tpmanley/dogcage/(list of files, cad)

Other CAD files:
mech/doorarm.skp
mech/servoarm.skp
mech/servomount.skp
