tpmanley/dogcage/hw/dogcage.pdf

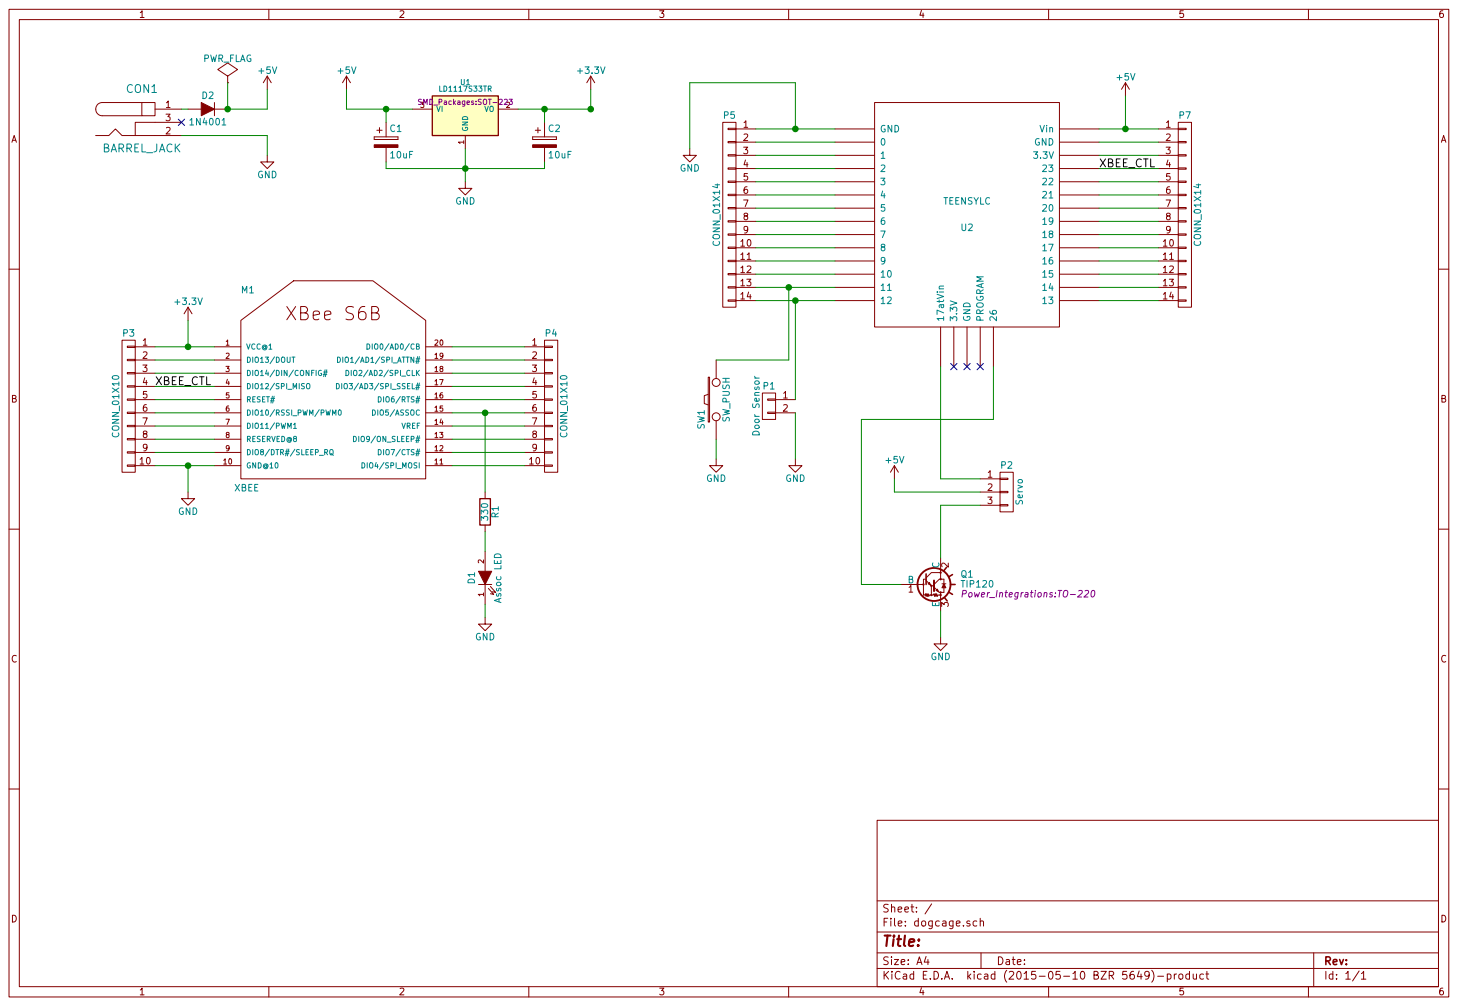
[picture p1: page 1]

4 | XBEE_CTL | 4
10 | 10
11 | 11
12 | 12
13 | 13

File: dogcage.sch Sheet: /
Id: 1/1 Title:
