tpmanley/dogcage/hw/dogcage.kicad_pcb

## KiCad design hw/dogcage.kicad_pcb (2015-08-02)

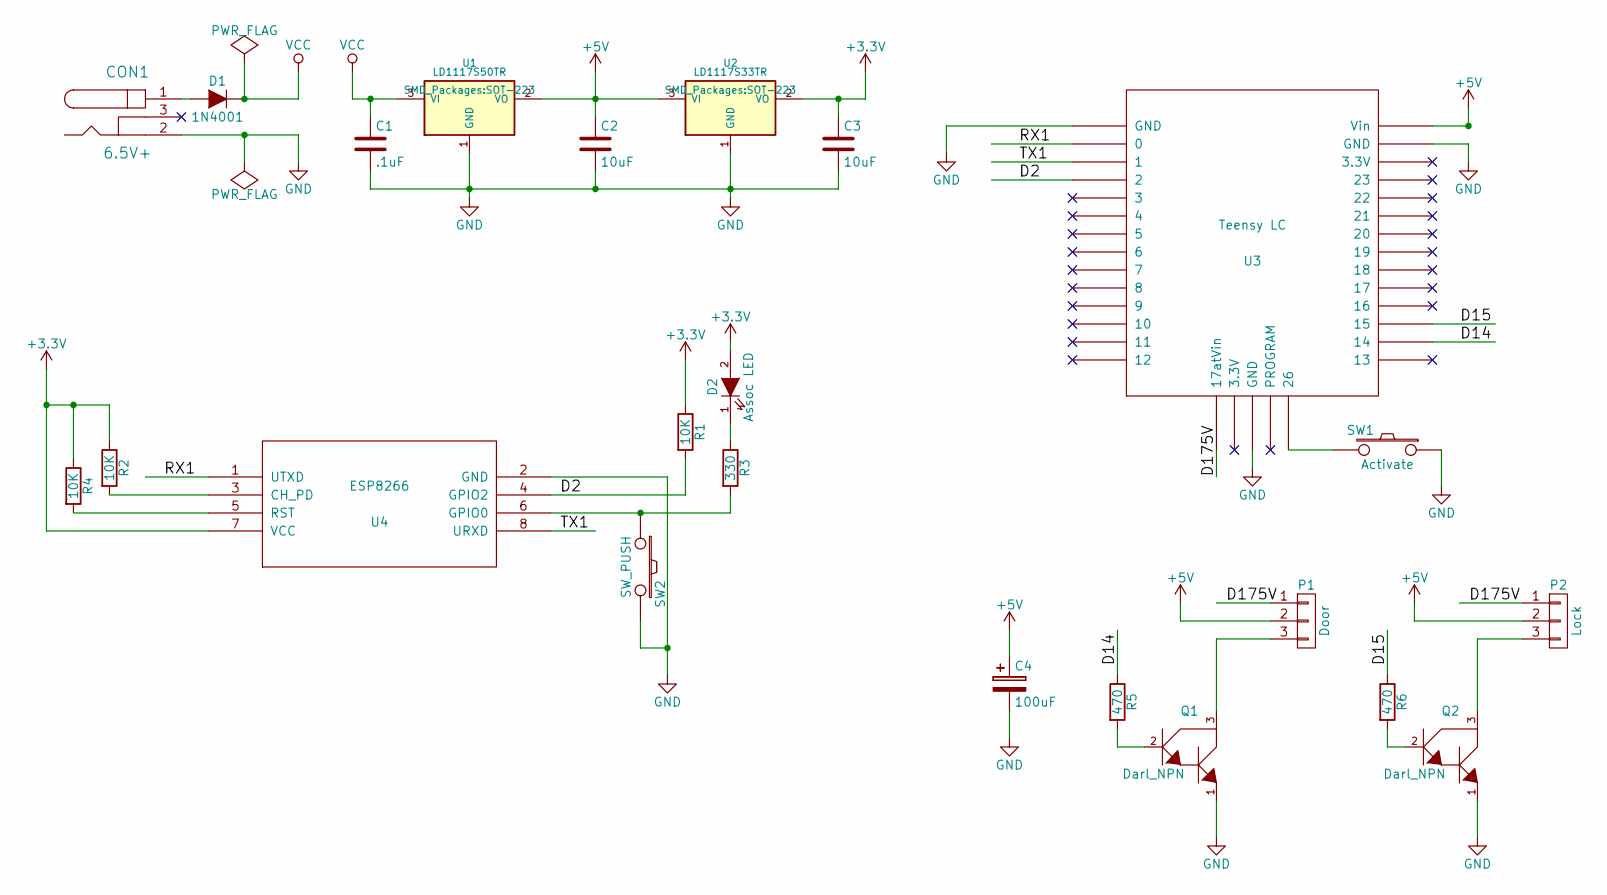
[picture p2: schematic dogcage.sch]

Parts:
C1: .1uF; C_0805_HandSoldering
C2, C3: 10uF; C_0805_HandSoldering
C4: 100uF; c_elec_3x5.3
CON1: 6.5V+; BARREL_JACK-ROUND_TH
D1: 1N4001; Diode_DO-41_SOD81_Horizontal_RM10
D2: Assoc LED; LED-0805
P1: Door; Pin_Header_Straight_1x03
P2: Lock; Pin_Header_Straight_1x03
Q1, Q2: Darl_NPN; DPAK-2
R1, R2, R4: 10K; R_0805_HandSoldering
R3: 330; R_0805_HandSoldering
R5, R6: 470; R_0805_HandSoldering
SW1: Activate; SW_PUSH_SMALL
SW2: SW_PUSH; SW_SPST_FSMSM
U1: LD1117S50TR; SOT-223
U2: LD1117S33TR; SOT-223
U3: Teensy LC; Teensy-3.1
U4: ESP8266; ESP-01

Connections:
+3V3: C3.1, D2.2 (A), R1.1, R2.1, R4.1, U2.2 (VO), U4.7 (VCC)
+5V: C2.1, C4.1, P1.2, P2.2, U1.2 (VO), U2.3 (VI), U3.33 (Vin)
/D2: R1.2, U3.4 (2), U4.4 (GPIO2)
/D14: R5.1, U3.21 (14)
/D15: R6.1, U3.22 (15)
/D175V: P1.1, P2.1, U3.15 (17atVin)
/RX1: U3.2 (0), U4.1 (UTXD)
/TX1: U3.3 (1), U4.8 (URXD)
GND: C1.2, C2.2, C3.2, C4.2, CON1.2, Q1.1, Q2.1, SW1.1, SW2.2, U1.1 (GND), U2.1 (GND), U3.1 (GND), U3.17 (GND), U3.32 (GND), U4.2 (GND)
unnamed: CON1.1, D1.2 (A)
unnamed: D2.1 (K), R3.1
unnamed: P1.3, Q1.3
unnamed: P2.3, Q2.3
unnamed: Q1.2, R5.2
unnamed: Q2.2, R6.2
unnamed: R2.2, U4.3 (CH_PD)
unnamed: R3.2, SW2.1, U4.6 (GPIO0)
unnamed: R4.2, U4.5 (RST)
unnamed: SW1.2, U3.19 (26)
VCC: C1.1, D1.1 (K), U1.3 (VI)

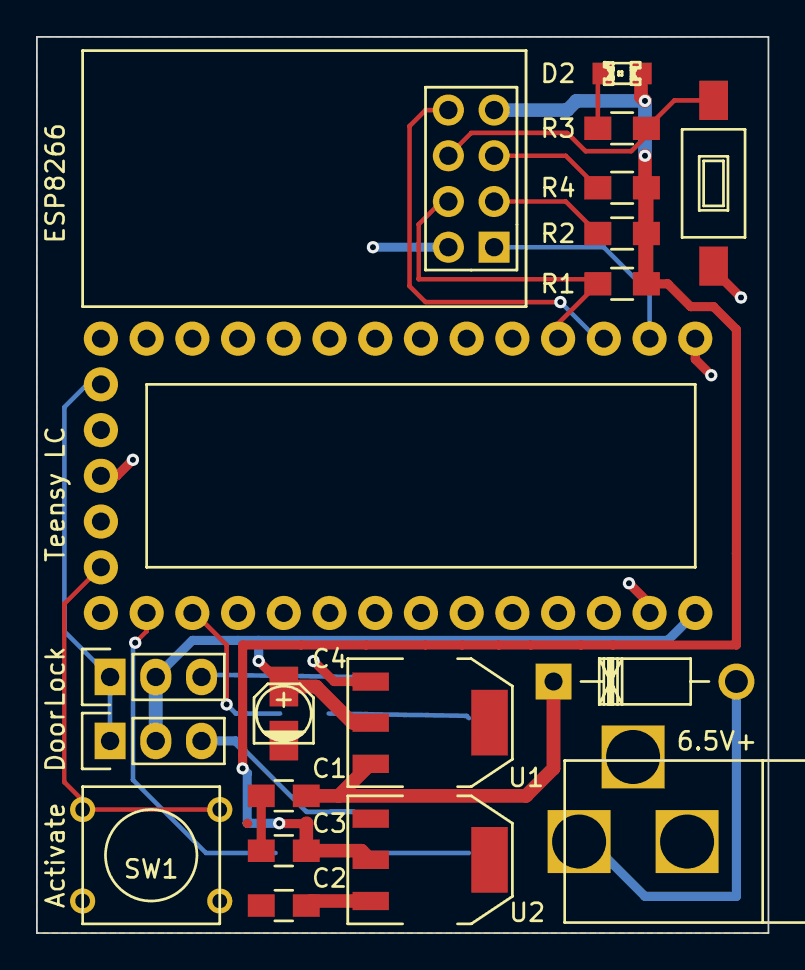
[picture p3: board dogcage.kicad_pcb from above]

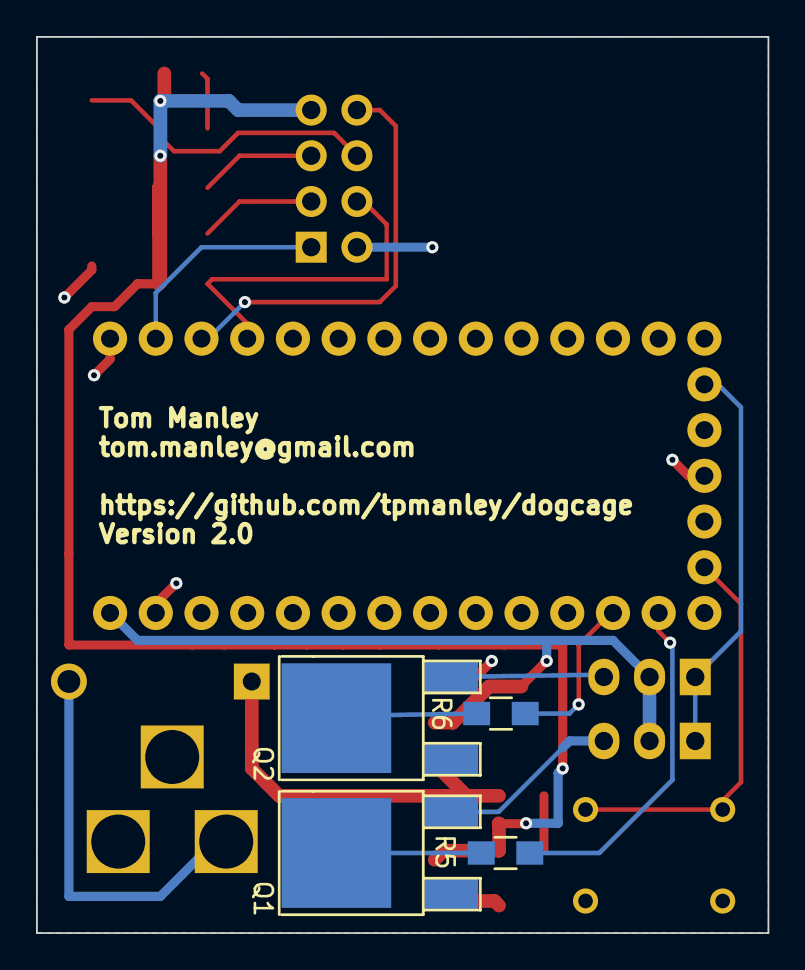
[picture p4: board dogcage.kicad_pcb from below]

Board: 2 copper layers, 40.6 x 49.8 mm, 23 parts (4 on the bottom side), 20 nets.
