tpmanley/dogcage/(threads)

Thread 4 (2015-06-17):

Resistor on Q1

Circuitsoft, 2015-06-17:
The TIP120 has a B-E voltage drop of 2.5v max, and an hFE around 2500 at a 4A load. Having the transistor directly connected to the pin on the teensy could be potentially damaging to the I/O pin. A 470 ohm resistor will provide almost 2mA, which should be plenty to saturate the TIP120. I would also recommend a bulk filter capacitor (100uF or so) across power to the servo to make sure current draw pulses don't cause random resets in the controllers.

tpmanley, 2015-06-18:
Thanks for the review Alex! You made great points and I updated the schematic.

Closed 2015-06-18.
