tpmanley/dogcage/(commit log)

2015-04-18 Initial commit for arduino powered dog cage opener
2015-04-18 LED will now always blink in loop
2015-04-25 Added door open/close sensor
2015-04-26 Button now has pullup and just connects pin to ground
2015-04-26 Added pullup to door sensor which is now connected from pin to ground
2015-04-26 Initial commit of kicad schematic
    [dogcage.sch]
2015-04-26 Cleaned up schematic and fixed ERC errors
    [dogcage.sch]
2015-04-26 Added assoc LED and started on PCB
    [dogcage.kicad_pcb, dogcage.sch]
2015-04-30 Add protection diode to input power line
    [dogcage.sch]
2015-05-02 Added connectors to XBee and Teensy
    [dogcage.sch]
2015-05-16 Fixed diode orientation and layout WIP
    [dogcage.kicad_pcb, dogcage.sch]
2015-05-16 Fixed cap and resistor footprints, improved overall placement
    [dogcage.kicad_pcb]
2015-05-17 Fixed orientation of LED
    [dogcage.sch]
2015-05-17 Moved XBee control line to make layout easier
    [dogcage.sch]
2015-05-17 Layout checkpoint
    [dogcage.kicad_pcb]
2015-05-19 Routing complete
    [dogcage.kicad_pcb, dogcage.sch]
2015-05-19 Updated design rules for oshpark, getting drc failures on vias
    [dogcage.kicad_pcb]
2015-05-22 Fixed drc failure, moved trace out of keep-out zone
    [dogcage.kicad_pcb]
2015-05-22 Generated gerbers and drill file
    [dogcage-B_Cu.gbl, dogcage-B_Mask.gbs, dogcage-B_SilkS.gbo, dogcage-Edge_Cuts.gbr, dogcage-F_Cu.gtl, dogcage-F_Mask.gts, dogcage-F_SilkS.gto, dogcage.drl]
2015-05-22 Fixed front silkscreen, added name/email to back
    [dogcage.kicad_pcb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]
2015-05-22 Removed P2 from front silkscreen
    [dogcage.kicad_pcb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]
2015-05-22 Added 'Trigger' to silkscreen
    [dogcage-B_Cu.gbl, dogcage-B_Mask.gbs, dogcage-B_SilkS.gbo, dogcage-Edge_Cuts.gbr, dogcage-F_Cu.gtl, dogcage-F_Mask.gts, dogcage-F_SilkS.gto, dogcage.drl]
2015-05-26 Initial commit of servo arm sketchup
    [servoarm.skp]
2015-05-26 Servo arm now one continguous piece
    [servoarm.skp, servoarm~.skp]
2015-06-01 First version of doorarm
    [doorarm.skp]
2015-06-01 Fit in flat servo connector instead of spline
    [servoarm.skp, servoarm~.skp]
2015-06-03 Arm now engulfs the servo horn
    [servoarm.skp]
2015-06-04 Updated door arm design to match servo arm design
    [doorarm.skp]
2015-06-04 Modified for 3d print compatibility. Printed 6-3-15.
    [servoarm.skp]
2015-06-04 Added rounded end to part that attaches to the cage
    [doorarm.skp]
2015-06-05 First version of servo mount
    [servomount.skp]
2015-06-05 Wrap around entire servo
    [servomount.skp]
2015-06-07 Changed screw holes to 1.1mm radius
    [servomount.skp]
2015-06-09 Models as printed revision 1.
    [doorarm.skp, servomount.skp]
2015-06-10 Added cutout for wire and increased size of vertical supports
    [servomount.skp]
2015-06-11 Fixed ground fill around button
    [dogcage.kicad_pcb]
2015-06-11 Reorganized to more sensible repo structure
    [dogcage-B_Cu.gbl, dogcage-B_Mask.gbs, dogcage-B_SilkS.gbo, dogcage-Edge_Cuts.gbr, dogcage-F_Cu.gtl, dogcage-F_Mask.gts, dogcage-F_SilkS.gto, dogcage.drl]
2015-06-11 Fixed underside polygon mess into a nice plane.
    [servomount.skp]
2015-06-12 Renamed sketch to make Arduino IDE happy
2015-06-12 Added more support to make servo balance on bar
    [servomount.skp]
2015-06-14 Disable door sensor because it isn't working
2015-06-14 Change close position to match position of arm when door is closed
2015-06-18 Bulk cap to 5V and current limiting resistor to TIP120 base
    [dogcage.sch]
2015-07-11 Added lock servo
    [dogcage.sch]
2015-07-11 Added 5V regulator to schematic
    [dogcage.sch]
2015-07-17 Removed XBee, moved bulk cap to be close to servo
    [dogcage.sch]
2015-07-17 Removed Teensy breakout, still wiring up
    [dogcage.sch]
2015-07-17 Removed door sensor
    [dogcage.sch]
2015-07-17 Cleaned up Teensy connections, still getting DRC errors
    [dogcage.sch]
2015-07-19 Added pwr_flag to GND, fixed DRC failures
    [dogcage.sch]
2015-07-19 Switched to non-polarized caps on regulators
    [dogcage.sch]
2015-07-19 Placement in progress
    [dogcage.kicad_pcb, dogcage.sch]
2015-07-25 Swapped TIP120s out for generic Darlington NPN transistors
    [dogcage.sch]
2015-07-25 Changed NPN and button footprints to SMD
    [dogcage.sch]
2015-07-26 Moved servo power control GPIOs to other side of the Teensy
    [dogcage.sch]
2015-07-26 Changed barrel jack footprint to have round througholes
    [dogcage.sch]
2015-07-26 Placement is essentially done
    [dogcage.kicad_pcb, dogcage.sch]
2015-07-26 Partially routed
    [dogcage.kicad_pcb, dogcage.sch]
2015-07-26 More routing
    [dogcage.kicad_pcb]
2015-07-26 Everything connected except GND
    [dogcage.kicad_pcb]
2015-08-02 Almost made all GND connections
    [dogcage.kicad_pcb]
